zxkmm/attenuator/6g_att/6g_att.kicad_pcb

## KiCad design 6g_att/6g_att.kicad_pcb (2026-09-22)

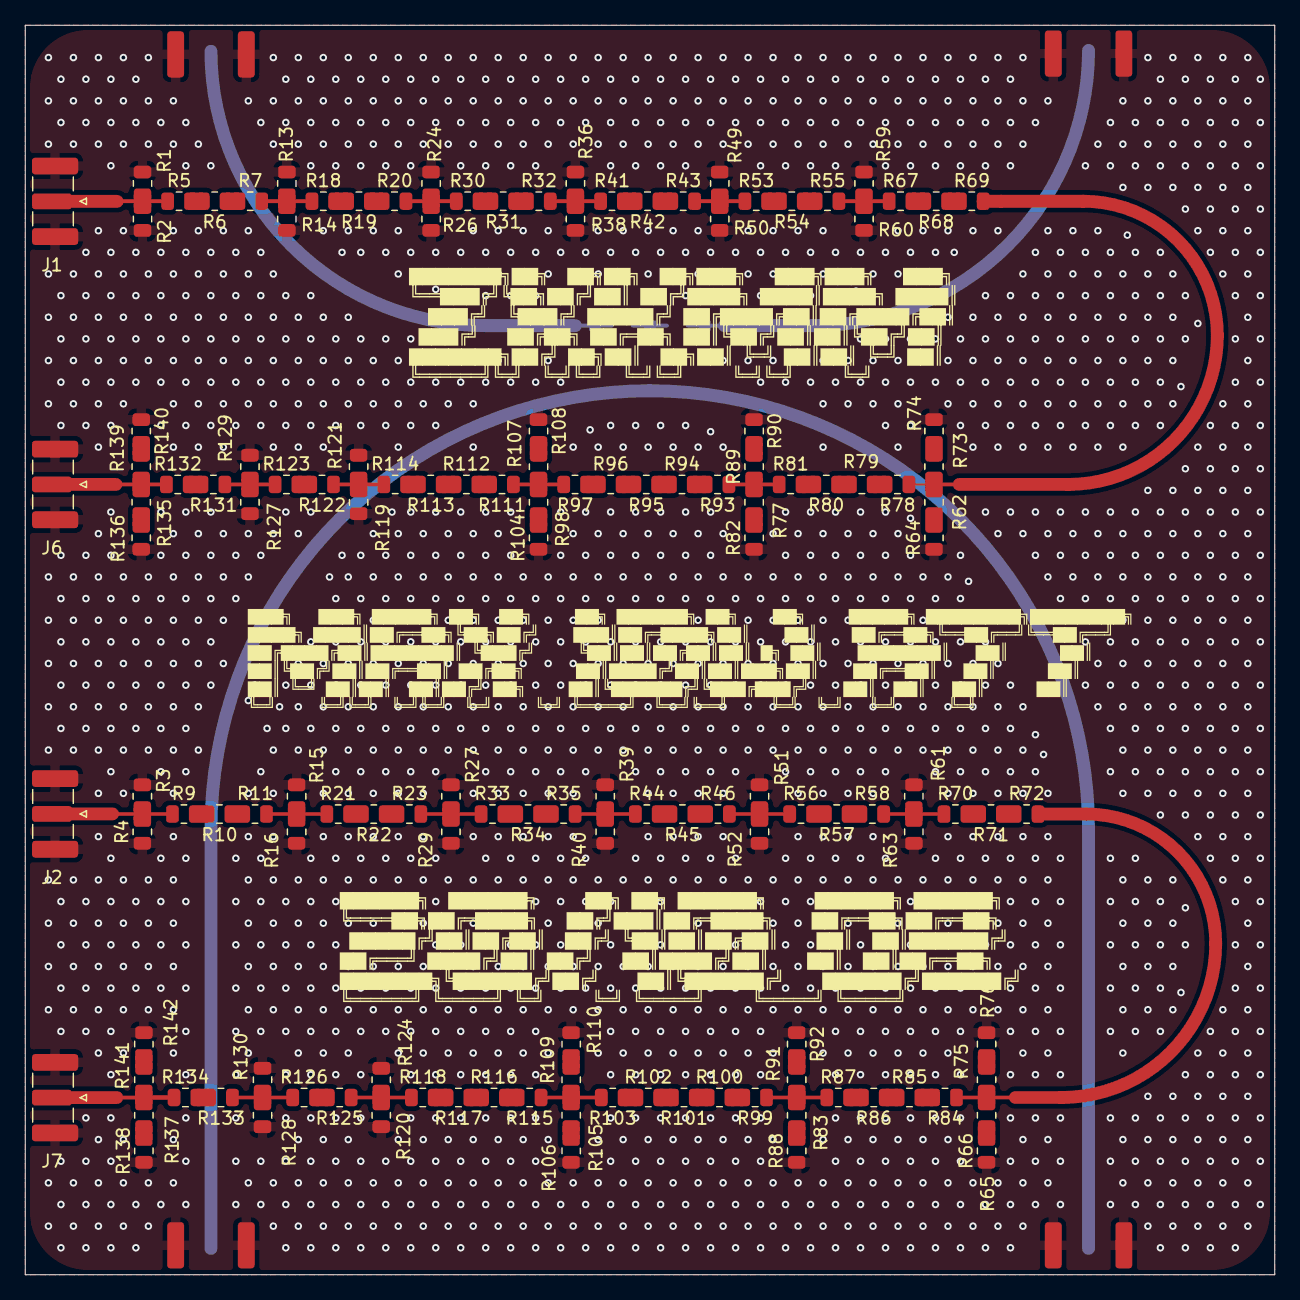
[picture p1: board 6g_att.kicad_pcb from above]

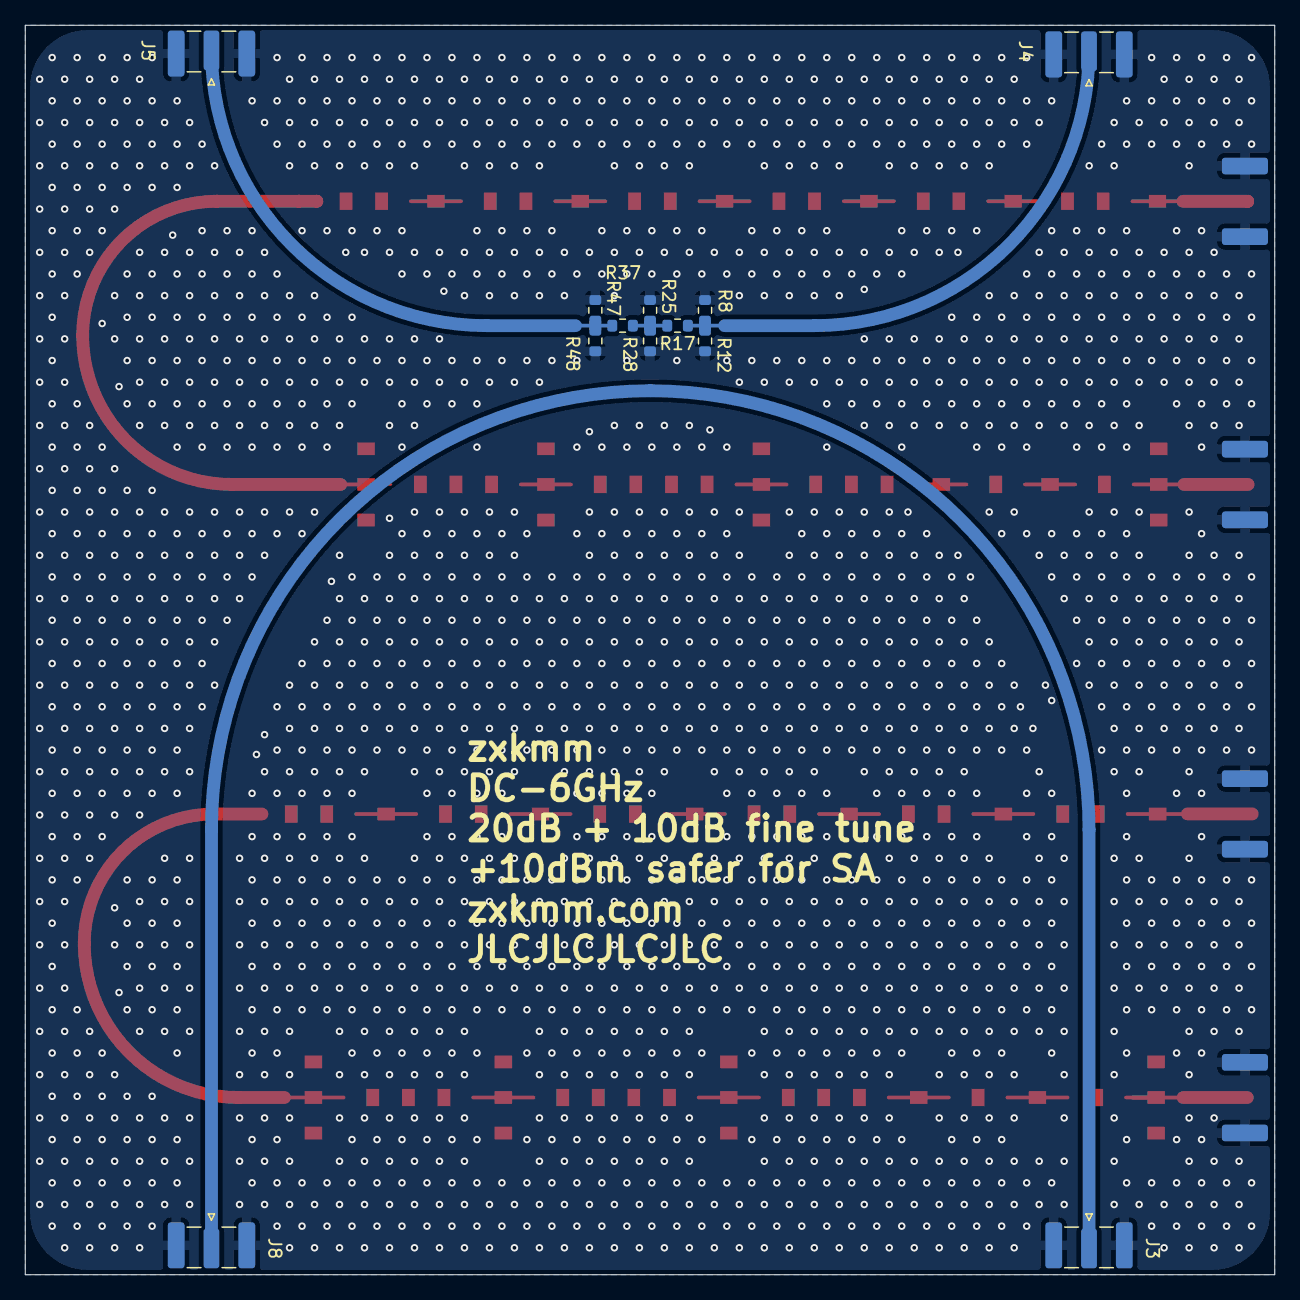
[picture p2: board 6g_att.kicad_pcb from below]

Board: 2 copper layers, 100.0 x 100.0 mm, 150 parts (12 on the bottom side), 93 nets.

Parts:
J1, J2, J3, J4, J5, J6, J7, J8: Conn_Coaxial; SMA_Samtec_SMA-J-P-H-ST-EM1_EdgeMount
R1, R2, R3, R4: 3.3k; R_0805_2012Metric
R5, R6, R7, R9, R10, R11, R18, R19, R20, R21, R22, R23, R30, R31, R32, R33, R34, R35, R41, R42, R43, R44, R45, R46, R53, R54, R55, R56, R57, R58, R67, R68, R69, R70, R71, R72, R97, R103: 1; R_0805_2012Metric
R8, R25: 97.6; R_0603_1608Metric
R12, R28: 6.98k; R_0603_1608Metric
R13, R14, R15, R16, R24, R26, R27, R29, R36, R38, R39, R40, R49, R50, R51, R52, R59, R60, R61, R63: 1.8k; R_0805_2012Metric
R17: 71.5; R_0603_1608Metric
R37: 0; R_0603_1608Metric
R47, R48: dnp; R_0603_1608Metric
R62, R65, R73, R75, R127, R128, R129, R130, R135, R136, R137, R138, R139, R140, R141, R142: 180; R_0805_2012Metric
R64, R66, R74, R76: 680; R_0805_2012Metric
R77, R82, R83, R88, R89, R90, R91, R92, R119, R120, R121, R124: 220; R_0805_2012Metric
R78, R79, R80, R81, R84, R85, R86, R87: 2.2; R_0805_2012Metric
R93, R94, R95, R96, R99, R100, R101, R102, R114, R118: 3.3; R_0805_2012Metric
R98, R104, R105, R106, R107, R108, R109, R110: 150; R_0805_2012Metric
R111, R112, R113, R115, R116, R117: 4.7; R_0805_2012Metric
R122, R123, R125, R126, R131, R132, R133, R134: 15; R_0805_2012Metric

Connections:
GND: J1.2 (Ext), J2.2 (Ext), J3.2 (Ext), J4.2 (Ext), J5.2 (Ext), J6.2 (Ext), J7.2 (Ext), J8.2 (Ext), R1.1, R2.1, R3.1, R4.1, R8.1, R12.1, R13.1, R14.1, R15.1, R16.1, R24.1, R25.1, R26.1, R27.1, R28.1, R29.1, R36.1, R38.1, R39.1, R40.1, R47.1, R48.1, R49.1, R50.1, R51.1, R52.1, R59.1, R60.1, R61.1, R63.1, R64.1, R66.1, R74.1, R76.1, R82.1, R88.1, R90.1, R92.1, R104.1, R106.1, R108.1, R110.1, R119.2, R120.2, R121.2, R124.2, R127.2, R128.2, R129.2, R130.2, R136.1, R138.1, R140.1, R142.1
unnamed: J1.1 (In), R1.2, R2.2, R5.1
unnamed: J2.1 (In), R3.2, R4.2, R9.1
unnamed: J3.1 (In), J8.1 (In)
unnamed: J4.1 (In), R8.2, R12.2, R17.1
unnamed: J5.1 (In), R37.2, R47.2, R48.2
unnamed: J6.1 (In), R132.1, R135.1, R139.1
unnamed: J7.1 (In), R134.1, R137.1, R141.1
unnamed: R5.2, R6.2
unnamed: R6.1, R7.1
unnamed: R10.1, R11.1
unnamed: R9.2, R10.2
unnamed: R11.2, R15.2, R16.2, R21.1
unnamed: R7.2, R13.2, R14.2, R18.1
unnamed: R17.2, R25.2, R28.2, R37.1
unnamed: R18.2, R19.2
unnamed: R19.1, R20.1
unnamed: R20.2, R24.2, R26.2, R30.1
unnamed: R21.2, R22.2
unnamed: R22.1, R23.1
unnamed: R23.2, R27.2, R29.2, R33.1
unnamed: R30.2, R31.2
unnamed: R31.1, R32.1
unnamed: R32.2, R36.2, R38.2, R41.1
unnamed: R33.2, R34.2
unnamed: R34.1, R35.1
unnamed: R35.2, R39.2, R40.2, R44.1
unnamed: R41.2, R42.2
unnamed: R42.1, R43.1
unnamed: R43.2, R49.2, R50.2, R53.1
unnamed: R44.2, R45.2
unnamed: R45.1, R46.1
unnamed: R46.2, R51.2, R52.2, R56.1
unnamed: R53.2, R54.2
unnamed: R54.1, R55.1
unnamed: R55.2, R59.2, R60.2, R67.1
unnamed: R56.2, R57.2
unnamed: R57.1, R58.1
unnamed: R58.2, R61.2, R63.2, R70.1
unnamed: R62.1, R69.2, R73.1, R78.1
unnamed: R62.2, R64.2
unnamed: R65.1, R72.2, R75.1, R84.1
unnamed: R65.2, R66.2
unnamed: R67.2, R68.2
unnamed: R68.1, R69.1
unnamed: R70.2, R71.2
unnamed: R71.1, R72.1
unnamed: R73.2, R74.2
unnamed: R75.2, R76.2
unnamed: R77.1, R81.1, R89.1, R93.1
unnamed: R77.2, R82.2
unnamed: R78.2, R79.2
unnamed: R79.1, R80.1
unnamed: R80.2, R81.2
unnamed: R83.1, R87.1, R91.1, R99.1
unnamed: R83.2, R88.2
unnamed: R84.2, R85.2
unnamed: R85.1, R86.1
unnamed: R86.2, R87.2
unnamed: R89.2, R90.2
unnamed: R91.2, R92.2
unnamed: R93.2, R94.2
unnamed: R94.1, R95.1
unnamed: R95.2, R96.2
unnamed: R96.1, R97.1
unnamed: R100.1, R101.1
unnamed: R99.2, R100.2
unnamed: R101.2, R102.2
unnamed: R102.1, R103.1
unnamed: R103.2, R105.1, R109.1, R115.1
unnamed: R98.2, R104.2
unnamed: R105.2, R106.2
unnamed: R97.2, R98.1, R107.1, R111.1
unnamed: R107.2, R108.2
unnamed: R109.2, R110.2
unnamed: R111.2, R112.2
unnamed: R112.1, R113.1
unnamed: R113.2, R114.2
unnamed: R114.1, R119.1, R121.1, R122.1
unnamed: R115.2, R116.2
unnamed: R116.1, R117.1
unnamed: R117.2, R118.2
unnamed: R118.1, R120.1, R124.1, R125.1
unnamed: R122.2, R123.2
unnamed: R123.1, R127.1, R129.1, R131.1
unnamed: R125.2, R126.2
unnamed: R126.1, R128.1, R130.1, R133.1
unnamed: R131.2, R132.2
unnamed: R133.2, R134.2
unnamed: R135.2, R136.2
unnamed: R137.2, R138.2
unnamed: R139.2, R140.2
unnamed: R141.2, R142.2
