zxkmm/attenuator/(commit log)

2026-09-22 fix conn
    [6g_att.csv, 6g_att.kicad_pcb]
2026-09-22 stitch for last commit
    [6g_att.kicad_pcb]
